kyledavid36/SE_project/KD V&V Test Report Final.pdf

# Test Reportfor Completed PCBs

## Follow-up from test plan for PCB1:

This section will comment on passed and failed criteria with notes taken into consideration and debugging measures taken.

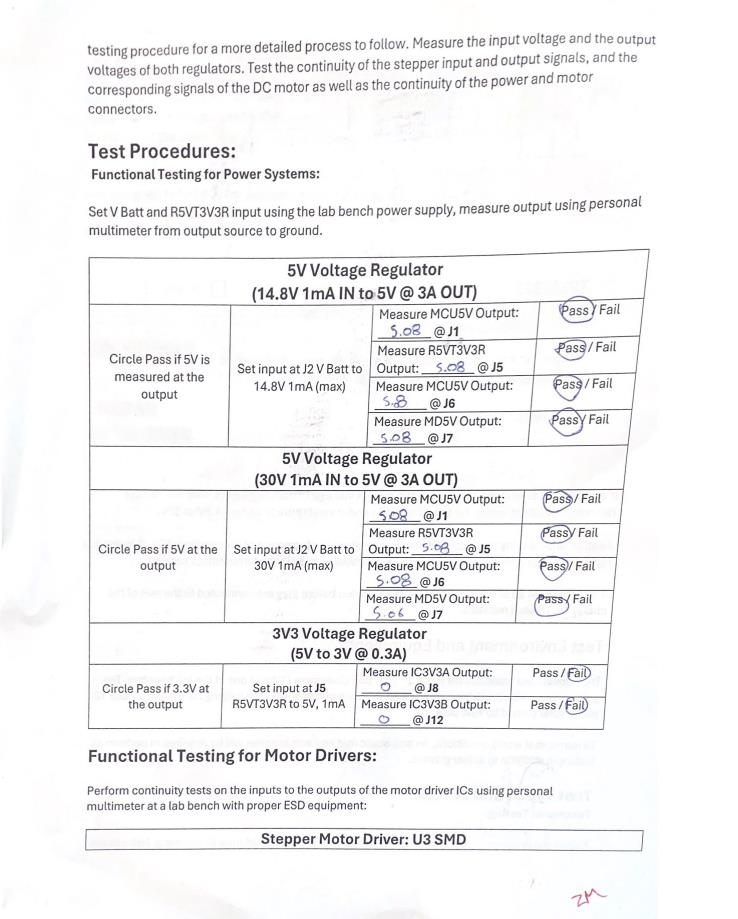
[picture p21: figure]

During the test procedures, PCB1 passed all the 5V tests but failed the 3V3 tests. The TPS62932 regulator responsible for converting 5V to 3.3 was misaligned as shown in the x-rayed image below. It was also observed that both diodes meant to indicate the 5V and 3V3 rails had been energized were backwards. Further debugging is required to determine the solution for these issues. More on debugging PCB1 later.

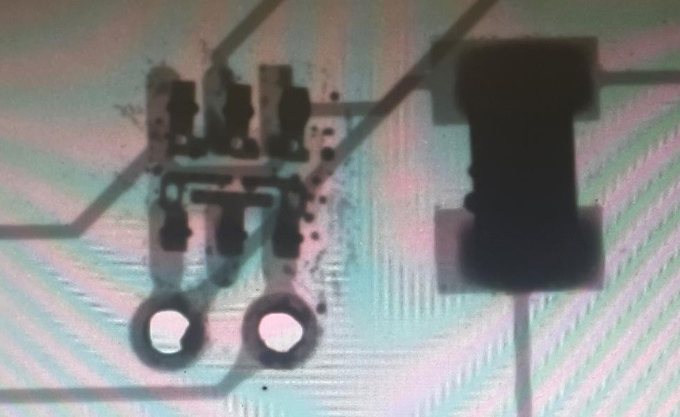
[picture p22: figure]

After the x-ray images were taken, the misaligned TPS62932 was replaced with a new one and resoldered to the board with a hot air rework station. Still the circuit did not perform as expected. Later, once the thermal images were taken, it was observed that the circuit was drawing current through the 5V regulator as expected but not through the 3V3 regulator as hoped. This can be shown in the figure below with the 5V regulator showing the highest temperature and the surrounding area along certain traces glowing red.

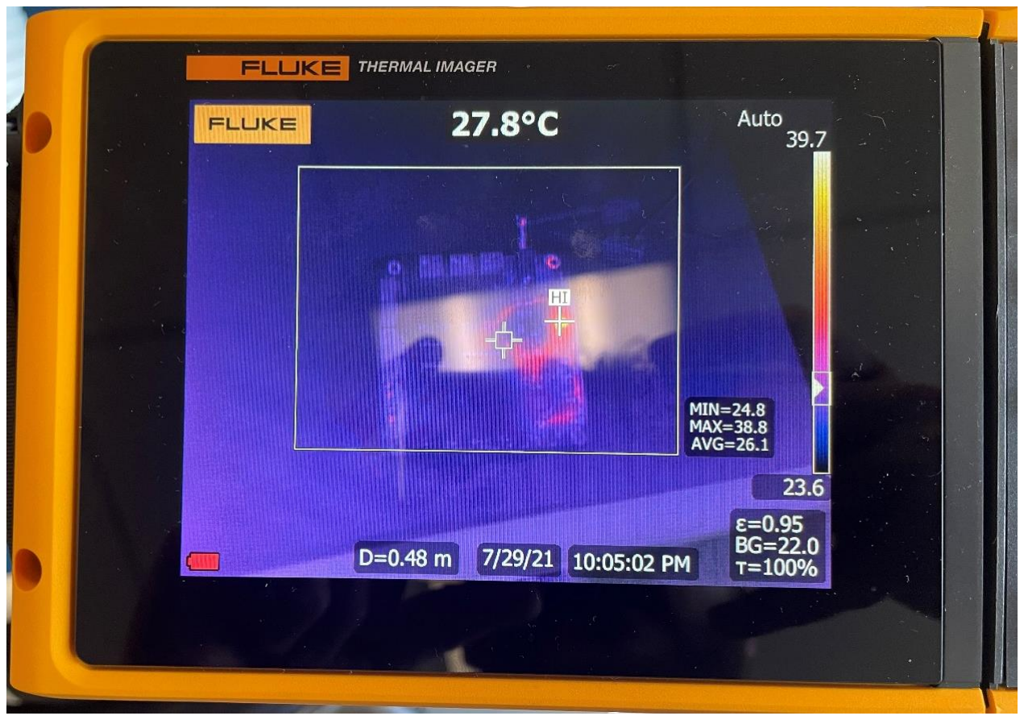
[picture p23: figure]

Commenting on the results from the motor drivers, the signal continuity could not be measured between their input and output pins since there is amplifier circuitry between them. This means that the functional tests for both U3 and U4 would fail.
The same ICs were tested while power was being supplied to the EN and Vs pins, 0.5V was found at the EN pin instead of 5V additional errors were found for U3. Further debugging for both motor driver ICs is required to determine the source of these errors.
Stepper Motor Driver: U3 SMD

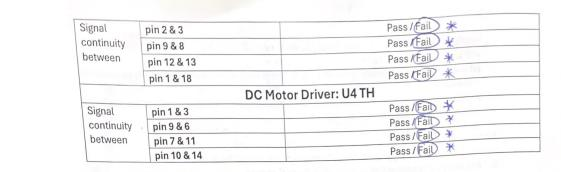
[picture p24: figure]

The remainder of tests passed for the motor and power connectors. Below are Zach McEwen’s notes from testing the PCB1.


## Results from PCB2:

This section will cover testing of PCB2 and debugging actions taken and next steps. The first image below shows solder paste being applied to PCB2 and the next image shows it after the SMD components have been placed.

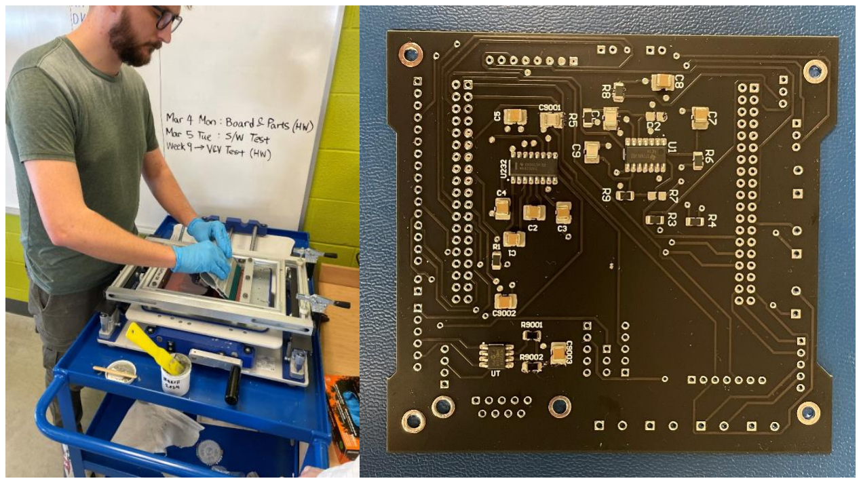
[picture p25: figure]

Once the components had been placed the board was place in the Protoflow oven. Unfortunately the graph for this pass was lost.

### Soldering TH components:

Soldering the various headers and terminal connectors for PCB2 was really fun, with the main challenging being finding a soldering iron that wasn’t corroded. I found that applying plenty of flux and tinning the tip of the soldering iron help things run smoothly. I will remember to flux the connection points on the board before inserting the headers. Below is an image of PCB2 partially completed with plenty of flux on the many of the connection points.

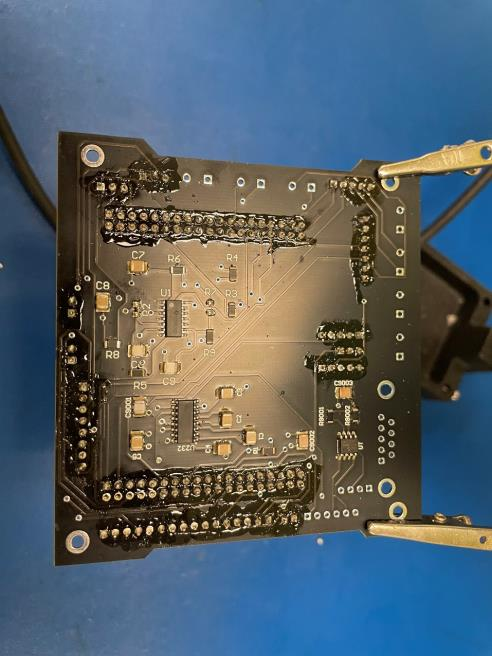
[picture p26: figure]

One flaw in the design of PCB2 is the placement of CONN 6 POS Header P12000 and 2 Pin Headers P1 and P2 which sit below the STM32 microcontroller making it not possible to interface with the keypad or limit switch circuitry designed into this board.
To remedy this, these pins will be desoldered and flipped so that the male pins are facing down and away from the MCU.
Another problem with this design was discovered when verifying the power planes that supply 3.3V and 5V to various parts of the circuit. The MCU5V plane when tested was found to be defective, as it did not take 5V from the J11005V terminal to pin 6 of CN7 38pin header (see path in grey highlighted in the image below).

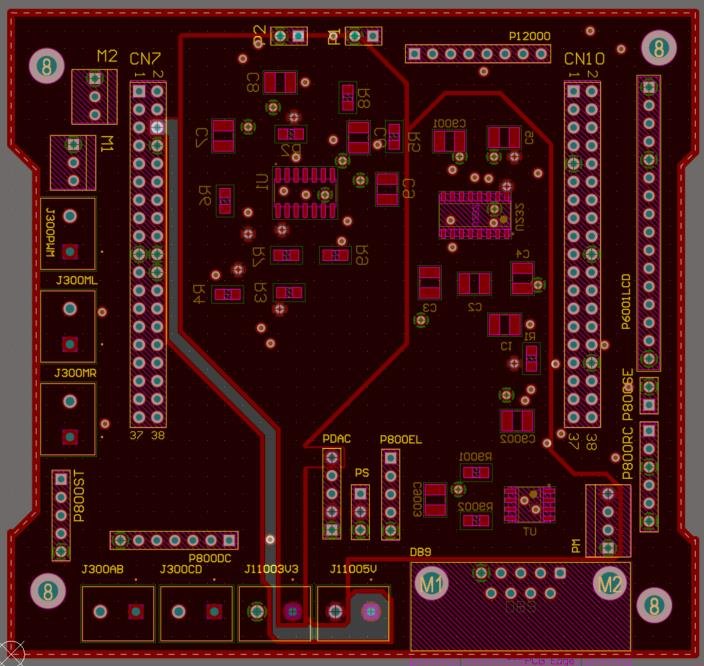
[picture p27: figure]

To remedy this, a wire was soldered to these pins to bridge the missing connection. See image below:

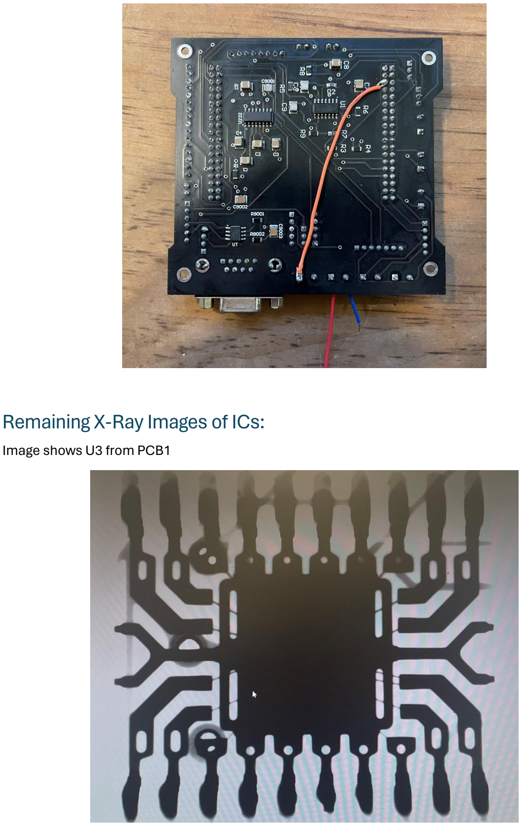
[picture p28: page 7]

## Remaining X-Ray Images of ICs:

Image shows U3 from PCB1

Image shows U4 from PCB1

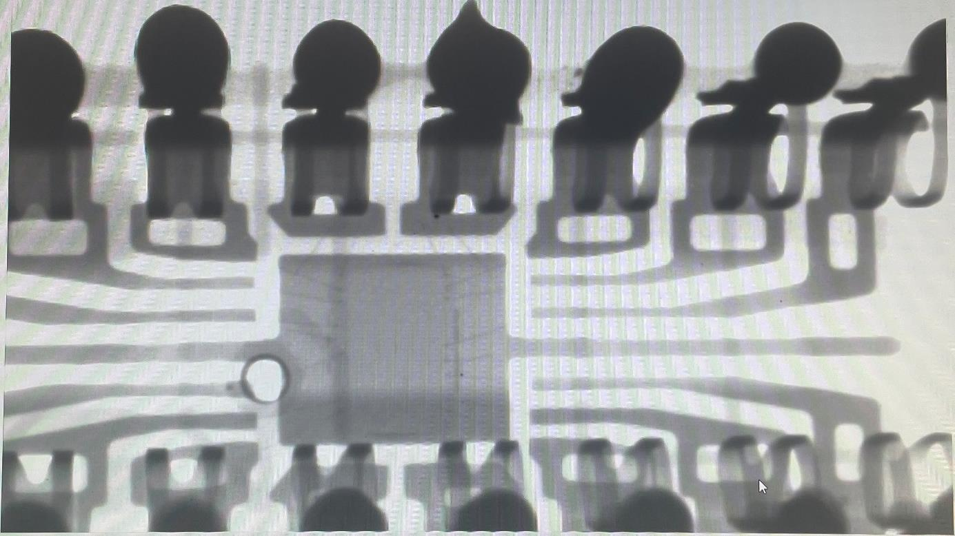
[picture p29: figure]
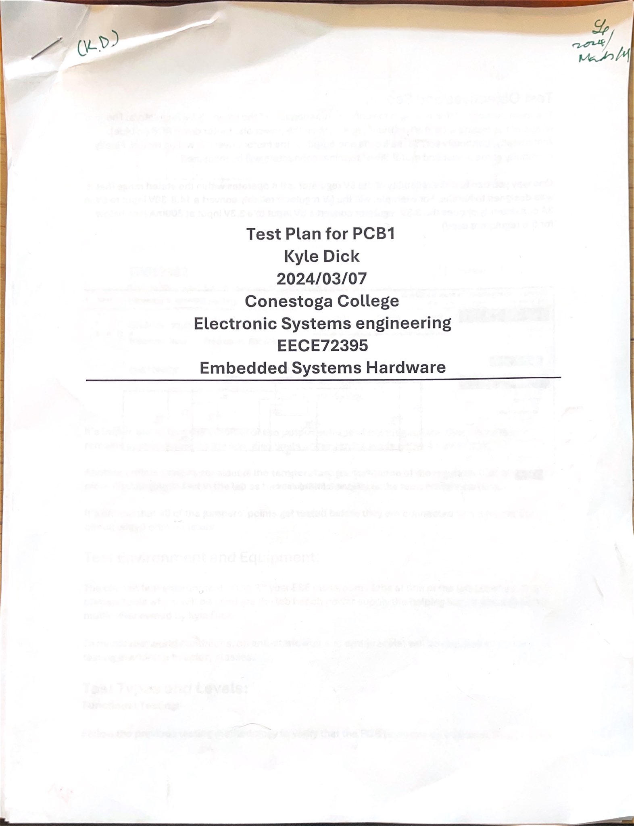
[picture p30: page 9]
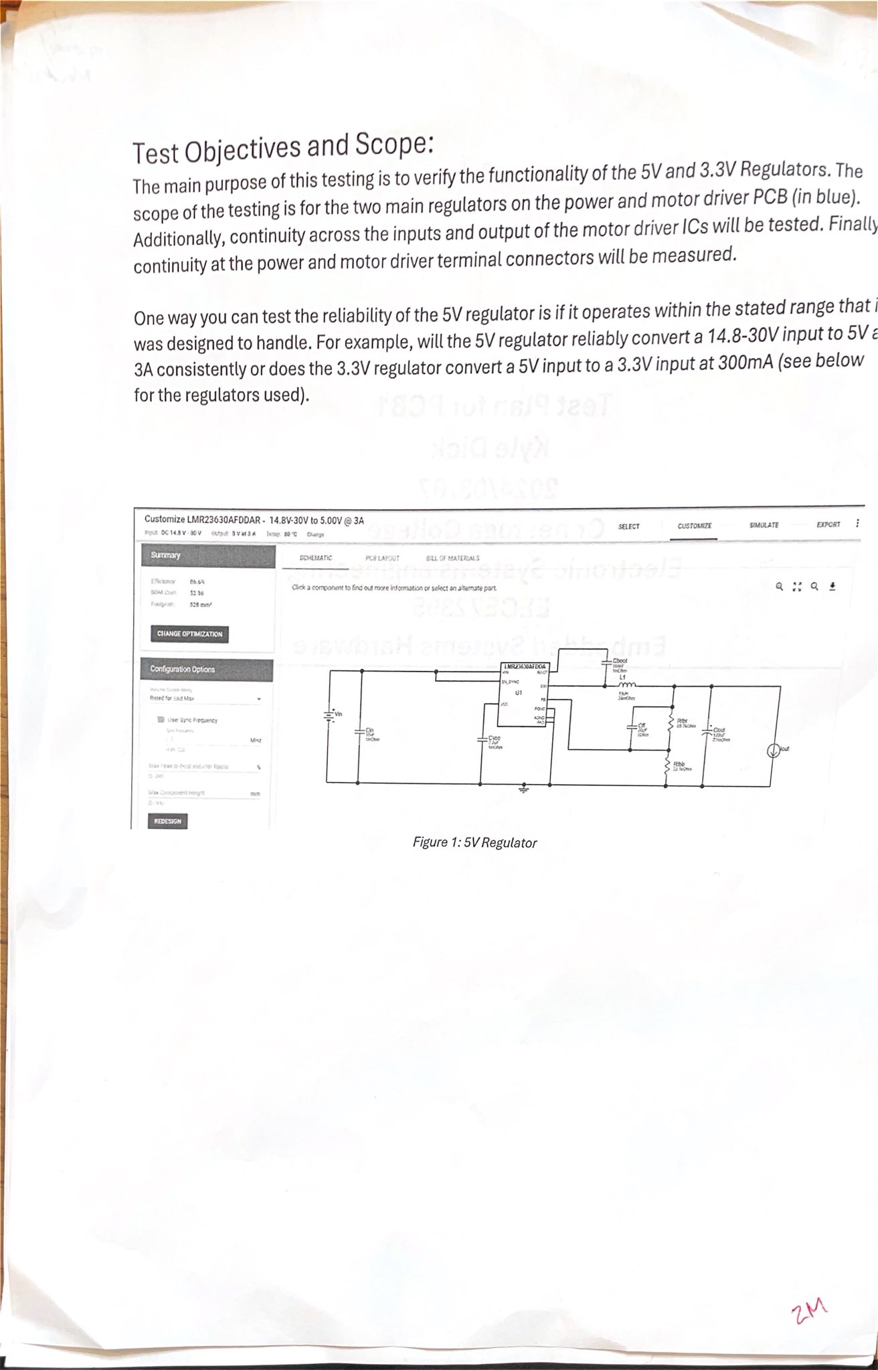
[picture p31: page 10]
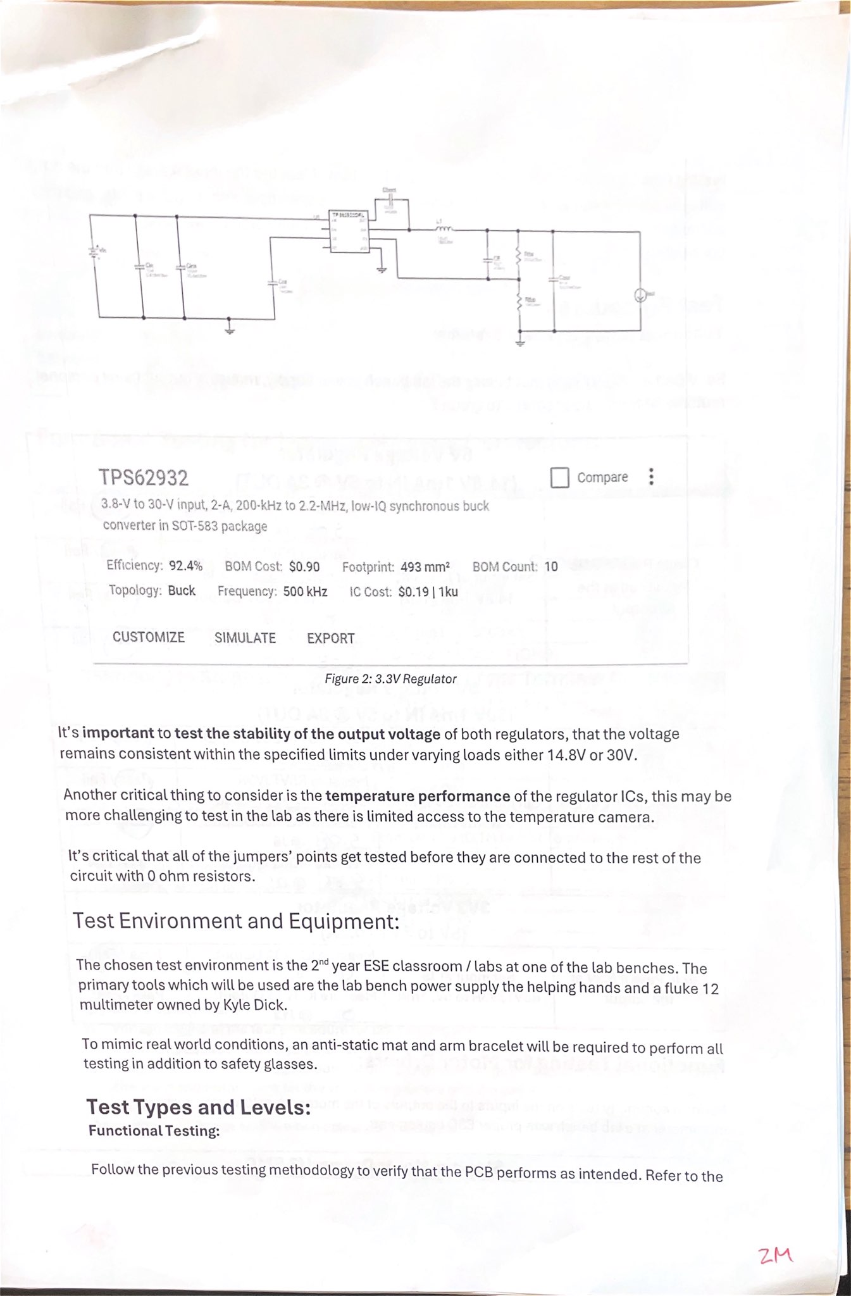
[picture p32: page 11]
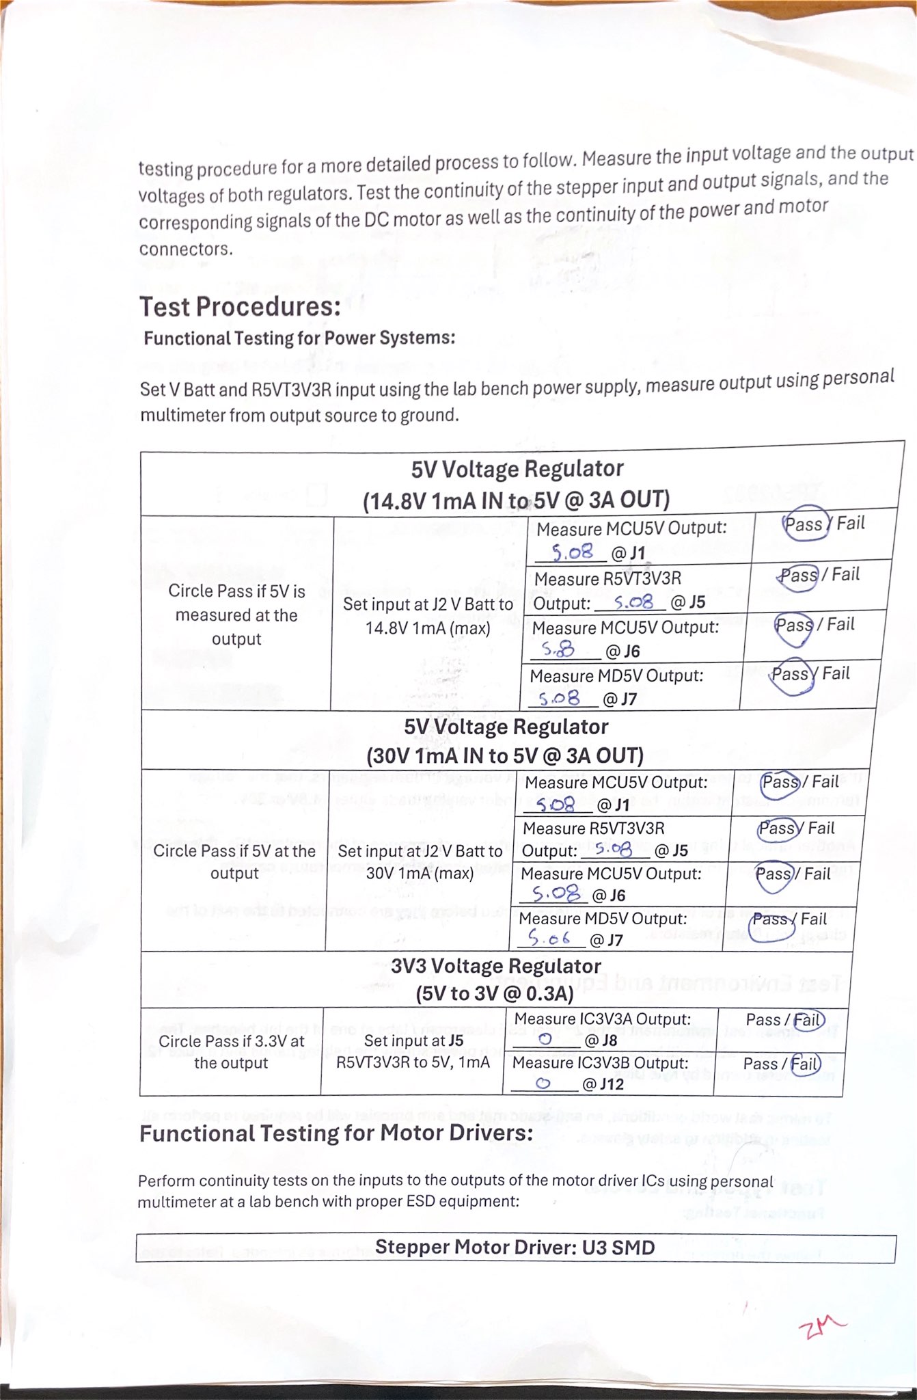
[picture p33: page 12]
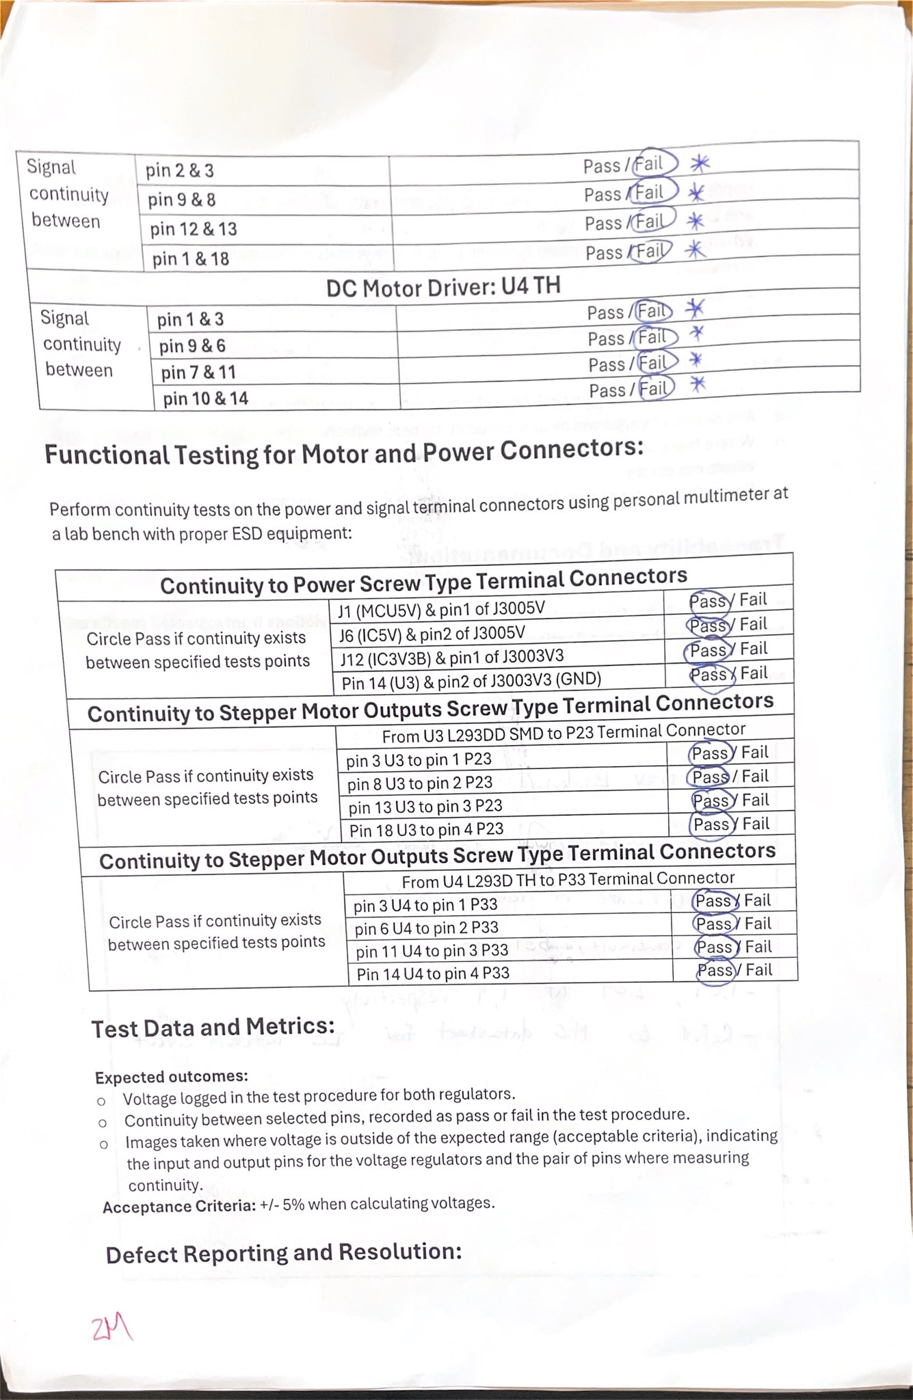
[picture p34: page 13]
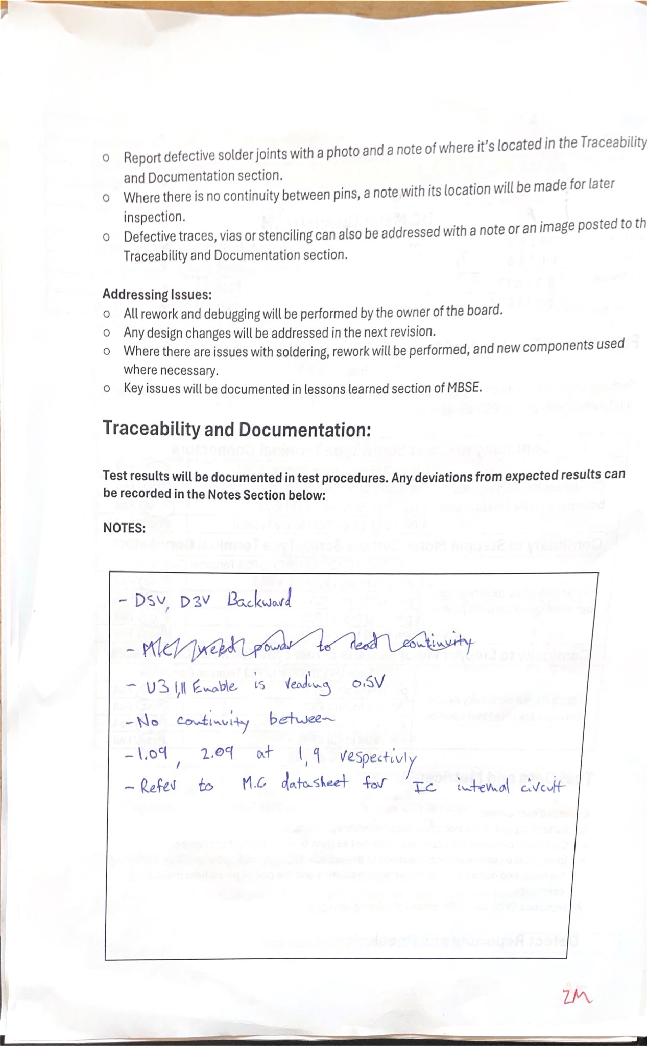
[picture p35: page 14]
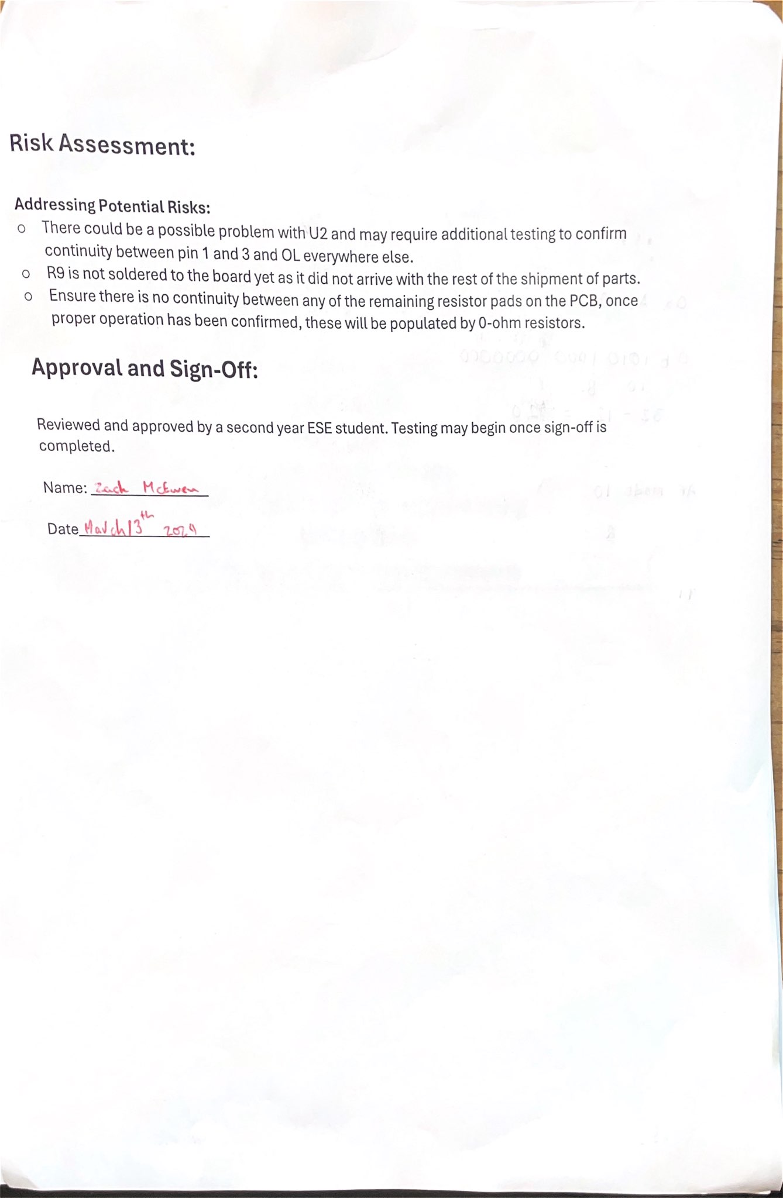
[picture p36: page 15]
