kyledavid36/SE_project/(list of files, drawings)

Other design files:
W5 - All Project, Schematic, PCB Files/PCB1/Headers.SchDoc
W5 - All Project, Schematic, PCB Files/PCB1/Motor Drivers.SchDoc
W5 - All Project, Schematic, PCB Files/PCB1/PCB1.PcbDoc
W5 - All Project, Schematic, PCB Files/PCB1/PCB1.PcbLib
W5 - All Project, Schematic, PCB Files/PCB1/PCB1.PrjPcb
W5 - All Project, Schematic, PCB Files/PCB1/PCB1.SCHLIB
W5 - All Project, Schematic, PCB Files/PCB1/Voltage_Regulators.SchDoc
W5 - All Project, Schematic, PCB Files/PCB2/CAN_Bus.SchDoc
W5 - All Project, Schematic, PCB Files/PCB2/DAC.SchDoc
W5 - All Project, Schematic, PCB Files/PCB2/LCD.SchDoc
W5 - All Project, Schematic, PCB Files/PCB2/Limit Switches.SchDoc
W5 - All Project, Schematic, PCB Files/PCB2/Main Encoder.SchDoc
W5 - All Project, Schematic, PCB Files/PCB2/MCU Header.SchDoc
W5 - All Project, Schematic, PCB Files/PCB2/PCB2.PrjPcb
W5 - All Project, Schematic, PCB Files/PCB2/RS232.SchDoc
W5 - All Project, Schematic, PCB Files/PCB2/Schlib2.SchLib
W5 - All Project, Schematic, PCB Files/PCB2/Servo Header.SchDoc
W5 - All Project, Schematic, PCB Files/PCB2/Top Level Hierarchy.SchDoc
